leenewbill/boise_bsides_2019/(commit log)

2025-02-02 Create directories for individual BSides board design projects. Move Slot Machine files to slot_machine directory. Initial check-in for Pomo Timer design.
2025-02-02 - Added functionality for setting timer minutes using BUTT1 button. - Removed unneeded bitfiles.
2026-10-26 Update SM1 documentation and add board assembly guide
