leenewbill/boise_bsides_2019/(notices)

Notices in the files:
pomo_timer/source/binary_to_bcd.v:
This source file is free software; you can redistribute it and/or modify
it under the terms of the GNU Lesser General Public License as published
If not, download it from http://www.opencores.org/lgpl.shtml
